Jzoe-hub/NightSecurityProject/docs/交接提示词_2026-07-17.md

# 项目交接提示词 — 2026-07-30

## 一、项目目标

在 STM32F103C8T6 硬件平台上从零构建一套**独居女性安防系统**：

- FreeRTOS 实时操作系统（10 个任务，当前 6 个已运行）
- MQTT 双向通信（ESP8266 + JSON，Phase 3）
- OTA 固件升级（Phase 4）
- Android APP（MVVM + Kotlin，Phase 5）
- 全部代码由 CubeMX 生成工程框架，原生 FreeRTOS API（xTaskCreate/vTaskDelay）写业务代码

**参考原项目**：`D:\keil.project2\NightSecurityProject\女性独家安防系统\`（裸机架构，算法和硬件接线可借鉴，代码不复用）。

---

## 二、真源文档（唯一事实来源）

| 文档 | 路径 | 说明 |
|---|---|---|
| **重构计划** | `docs/重构计划_从零开始.md` | 技术决策、配置、任务/IPC/算法设计，**权威文档** |
| 项目说明书 | `docs/项目说明书.md` | 系统框架、硬件、算法权重、状态机、MQTT协议、Phase规划 ✅ 已重写 |
| 调试手册 | `docs/调试手册.md` | 逐步测试指南 ✅ 已对齐当前代码 |
| 技术学习笔记 | `docs/技术学习笔记.md` | 学习记录（ADC坑、ppm换算、双电压等） |
| Git 使用教程 | `docs/Git使用教程.md` | Git 操作参考（含拆分commit方法） |

**任何技术决策以重构计划为准。所有修改涉及设计变更时同步更新重构计划。**

---

## 三、已完成阶段

### Phase 1 — 基础环境搭建（✅）

- CubeMX 完整配置（72MHz SYSCLK, FreeRTOS, 全部外设含 IWDG）
- 13/14 个 Lib 驱动完成（仅 esp8266 留空）
- ADC1 三通道扫描（CH0=M2Q, CH1=MQ7, CH4=火焰），TIM3 TRGO 触发 + DMA 循环搬运
- OLED I2C 驱动（百问网韦东山）+ ascii_font 字库
- OLED_Printf 已撤回（newlib-nano `%f` 需 `-u _printf_float` 链接选项）

### Phase 2 — FreeRTOS 任务（✅ 基本完成，本地调试中）

6 个任务已创建并运行：
| 任务 | 优先级 | 栈 | 周期 | 功能 |
|---|---|-----|---|---|
| SensorTask | 3 | 256 | 100ms | 读 8 类传感器，打包发队列 |
| SecurityTask | 4 | 512 | 100ms | 火灾/入侵评分 + 状态机 |
| AlarmTask | 5 | 256 | 50ms | 声光报警时序 |
| UITask | 2 | 384 | 200ms | OLED 三页 + 按键菜单 |
| FingerTask | 2 | 384 | 事件 | 指纹验证（已注释，等硬件） |
| WatchdogTask | 6 | 128 | 500ms | 心跳监控 + IWDG 喂狗 |

IPC 队列：`g_sensorQueue`（Sensor→Security）、`g_securityQueue`（Security→Alarm）

### 已完成的功能模块

- 传感器→判定→报警 完整链路
- 布防/撤防（KEY2 切换，全局变量 `g_sw_armed`，撤防=纯监控不报警）
- OLED 界面：监控页（传感器数据+ARM状态）/ 设置页（5 项阈值+方向调节）/ 报警页（霸屏+KEY1撤防退出）
- 阈值可调且 SecurityTask 实时生效
- 看门狗心跳监控（finger 心跳已注释）
- 蜂鸣器极性已确认（低电平触发，On=RESET/Off=SET）

---

## 四、当前进度 — Phase 2 本地调试

**编译通过，6 个任务运行。本地功能基本跑通。**

待完成：
- 蜂鸣器极性已修，测试通过
- RGB 极性和 CubeMX PinState 待确认
- 指纹、语音模块未到货，相关代码已注释
- 传感器阈值需根据实际读数调优
- 撤防→布防→触发→报警→KEY1 解除 完整流程待实体验证

---

## 五、关键文件和模块

### 项目结构

```
software/NightSecurity/
├── Core/                          ← CubeMX 生成，只在 USER CODE 区写
│   ├── Src/main.c                 ← HAL 初始化 + 调试代码 + 启动调度器
│   ├── Src/freertos.c             ← xTaskCreate（RTOS_THREADS）+ xQueueCreate（RTOS_QUEUES）
│   └── Src/adc.c / tim.c          ← 已改: ADC 三通道扫描、TIM3 TRGO
├── Lib/                           ← 硬件驱动层（不依赖 FreeRTOS）
│   ├── inc/ + src/                ← 13/14 完成，esp8266 留空
│   └── src/ascii_font.c           ← OLED 字库（百问网）
├── Task/                          ← 任务层
│   ├── inc/task_config.h          ← 结构体、队列句柄、任务句柄、心跳、阈值 声明
│   ├── src/task_config.c          ← 句柄定义
│   ├── src/task_sensor.c          ← ✅ 完整
│   ├── src/task_security.c        ← ✅ check_fire/intrusion/state_machine/dispatch
│   ├── src/task_alarm.c           ← ✅ alarm_fire/intrusion/idle
│   ├── src/task_ui.c              ← ✅ 三页显示+按键+菜单
│   ├── src/task_finger.c          ← ✅ 验证逻辑完成（未启用）
│   └── src/task_watchdog.c        ← ✅ 心跳检查+喂狗
└── NightSecurity.ioc              ← CubeMX 配置
```

### 最近修改的关键文件

- `Task/src/task_ui.c` — OLED 三段式界面，阈值全局共享（`uint16_t th_fire` 等），UI 最后改动较多
- `Task/src/task_security.c` — `check_fire` 使用阈值变量（`th_fire/th_smoke/th_co/th_temp`），`dispatch_alarm` 只在 level>0 时发送
- `Task/src/task_alarm.c` — 撤防时强制 `mode=0` + 丢弃队列旧命令
- `Lib/src/buzzer.c` — 蜂鸣器极性修正（低电平触发: On→RESET, Off→SET）
- `Core/Src/main.c` — `g_adc_raw` 去掉 static 供其他文件使用

---

## 六、下一步任务

### 立即可做

1. **本地调试** — 按 `docs/调试手册.md` 逐步验证：传感器读数、按键操作、布防报警、阈值调节
2. **阈值调优** — 实际测试环境中的传感器数值，调整 `th_fire/th_smoke/th_co/th_temp/th_pir`
3. **RGB 极性确认** — 共阳低亮逻辑已写对，CubeMX 初始 PinState 需确认
4. **SensorTask 加滤波** — 当前传感器原始值直接传给 SecurityTask，加上卡尔曼/EWMA 可减少误报（参考 `docs/重构计划_从零开始.md` 5.2 节）

### 模块到货后

5. 指纹（ZW101）→ 取消 FingerTask 注释，启用看门狗 finger 心跳
6. 语音（JQ8900）→已在 AlarmTask 中预留 `Voice_IO1/2_Trigger()`
7. ESP8266 → Phase 3，写 esp8266.c + CommTask + EspRxTask

### 后续 Phase

| Phase | 内容 |
|---|---|
| Phase 3 | MQTT + ESP8266 联网 |
| Phase 4 | OTA 固件升级 |
| Phase 5 | Android APP (Kotlin MVVM) |
| Phase 6 | 卡尔曼/EWMA 滤波 + 磨损均衡 |

---

## 七、Agent 宪法（必须遵守）

1. **重构计划是唯一事实来源** — 技术争论以 `docs/重构计划_从零开始.md` 为准
2. **先读计划再动手** — 先 Read 相关章节
3. **CubeMX USER CODE 区** — `freertos.c` 和 `main.c` 只在 USER CODE 标记之间写
4. **原生 FreeRTOS API** — `xTaskCreate`/`vTaskDelay`，不用 CMSIS_V2 的 `osThreadNew`
5. **Lib 不依赖 FreeRTOS** — 驱动层只提供纯逻辑接口
6. **一个文件一个模块** — Lib 12 个独立驱动 + Task 10 个任务文件
7. **计划同步** — 技术决策变更必须更新重构计划
8. **Git 提交粒度** — 每完成一小功能就 commit
9. **PC13 不用** — 驱动能力不足
10. **注释风格** — 中文盒式（函数名称/功能描述/输入参数/返回值），宏/变量一行注释，函数盒式可以详细
11. **代码注释禁止引用文档路径** — 代码只描述自身，文档归文档
12. **宏/变量注释只写一行"是什么"** — 原理推导放 docs，不放代码
13. **来源标注** — 每个驱动文件标注原作者（辰哥/百问网/GitHub 等）
14. **用户写代码，Agent 指导** — 不要未经允许自己改函数体，只写框架骨架和注释

---

## 八、验收标准

| 阶段 | 验收条件 |
|---|---|
| Phase 2 本地 | OLED 三页切换正常、按键布防/撤防、传感器数值变化、布防触发报警、撤防不报警、阈值调节生效 |
| Phase 2 稳定 | 蜂鸣器+RGB 按报警等级动作、看门狗正常、长时间运行不崩溃 |
| Phase 3 MQTT | APP 能看到实时传感器数据、能远程布防/撤防 |
| Phase 4 OTA | 一次完整固件升级成功 |
| Phase 5 APP | 数据展示+阈值调节+报警推送 |

---

## 九、已知风险

| 风险 | 影响 | 缓解 |
|---|---|---|
| 克隆 ST-Link 不稳定 | 调试困难 | ST-Link GDB server + Under Reset + Hardware reset 模式；备选 BOOT0 擦除 |
| SRAM 仅 20KB | 10 个任务可能栈溢出 | `CHECK_FOR_STACK_OVERFLOW`=Option1，每个任务用 `uxTaskGetStackHighWaterMark()` 实测 |
| PC13 备份域 | 不能做输出 | 已放弃，用 PA5（蜂鸣器）和 RGB |
| CubeMX 重新生成 | 覆盖手写代码 | 手写代码只在 USER CODE 区 |
| Flash 寿命 10K 次 | 日志写入磨损 | Phase 6 做磨损均衡 |
| 蜂鸣器/RGB 极性 | 声光效果反了 | Buzzer 已修正（低触发），RGB 代码正确，PinState 待确认 |
| 指纹模块心跳 | FingerTask 死等会误触发看门狗 | 已注释，启用前把 `g_heartbeat_finger++` 放在 `finger_wait_touch` 之前 |
| 报警队列旧数据 | 撤防后残留报警命令 | AlarmTask 撤防时丢弃队列 + force mode=0 |
| 传感器阈值硬编码 | 与设置页不联动 | 已改为全局变量 `th_fire/th_smoke/th_co/th_temp/th_pir`，UI 和 SecurityTask 共享 |
