Jzoe-hub/NightSecurityProject/docs/重构计划_从零开始.md

# 女性安防系统 — 从零重构计划

> **原则**：完全从 STM32CubeMX 开始配置，重新生成工程，不复用现有裸机代码的架构，只复用硬件驱动逻辑。

---

## 一、项目目标

在现有硬件基础上，从零构建一个：

- **FreeRTOS** 实时操作系统驱动
- **MQTT** 双向通信（TLS 加密 + 遗嘱消息 + 心跳）
- **OTA 固件升级**（ESP8266 下载 → STM32 Bootloader 校验写入）
- **Android APP 重构**（MVVM + 通知 + 图表 + 多设备管理）

的**独居女性安防系统**。

---

## 二、硬件资源总览

| 资源 | 型号 | 接口 | 占用引脚 |
| --- | --- | --- | --- |
| MCU | STM32F103C8T6  | — | — |
| WiFi | ESP8266-01S | USART2 | PA2(TX), PA3(RX) |
| 烟雾传感器 | MQ-2 | ADC1_CH0 | PA0 |
| CO 传感器 | MQ-7 | ADC1_CH1 | PA1 |
| 火焰传感器 | 火焰模块(四线) | ADC1_CH4 + GPIO | PA4(AO), PA11(DO) |
| PIR 人体红外 | HC-SR501 | GPIO | PA8 |
| 人体雷达 | LD2410C | USART1 | PA9(TX), PA10(RX) |
| 温湿度 | DHT11 | GPIO | PA12 |
| 指纹模块 | ZW101 | USART3 | PB10(TX), PB11(RX) |
| 指纹触摸 | ZW101 TOUCH | GPIO | PA6 |
| OLED | 0.96寸 I2C | I2C1 | PB8(SCL), PB9(SDA) |
| 语音模块 | JQ8900 | GPIO | PB6(IO1), PB7(IO2), PB3(IO3), PB4(IO4), PB12(BUSY) |
| 蜂鸣器 | 有源蜂鸣器 | GPIO | PA5 |
| RGB LED | 共阳RGB | GPIO | PB0(R), PB1(G), PA7(B) |
| 按键 ×3 | 轻触按键 | GPIO | PB13(K1), PB14(K2), PB15(K3) |

**Flash 规划（64KB）：**

| 区域 | 大小 | 地址 |
| --- | ---- | --- |
| Bootloader  | 16KB | 0x08000000 - 0x08003FFF |
| Application | 44KB | 0x08004000 - 0x0800EFFF |
| Config/Log  | 4KB  | 0x0800F000 - 0x0800FFFF |

---

## 三、CubeMX 配置清单

### 3.1 基础配置

```
MCU: STM32F103C8T6
Package: LQFP48
Clock: HSE 8MHz → PLL ×9 → SYSCLK 72MHz
       APB1 = 36MHz, APB2 = 72MHz
Debug: Serial Wire (SWD) — PA13, PA14（关闭 JTAG，释放 PB3/PB4 给 JQ8900）
Timebase: TIM4（SysTick 专供 FreeRTOS，TIM4 专供 HAL，避免抢占冲突）
```

### 3.2 FreeRTOS 配置

```
Middleware → FREERTOS → Interface: CMSIS_V2

Kernel Setting:
  - configUSE_PREEMPTION           = 1
  - configCPU_CLOCK_HZ            = SystemCoreClock (72MHz)
  - configTICK_RATE_HZ            = 1000
  - configMAX_PRIORITIES          = 56       (CMSIS_V2 固定: 7组×8子优先级)
  - configMINIMAL_STACK_SIZE      = 128 Words
  - configTOTAL_HEAP_SIZE         = 10240    (10KB, 保守)
  - configMAX_TASK_NAME_LEN       = 16
  - configUSE_16_BIT_TICKS        = Disabled (0 → 32位, 最长49.7天不溢出)
  - configIDLE_SHOULD_YIELD       = Enabled
  - configCHECK_FOR_STACK_OVERFLOW = Option 1 (开发阶段必开, 任务栈溢出时检测)
  - configUSE_MUTEXES             = Enabled
  - configUSE_RECURSIVE_MUTEXES   = Enabled
  - configUSE_COUNTING_SEMAPHORES = Enabled
  - configUSE_QUEUE_SETS          = Enabled (SecurityTask 同时等传感器队列+命令队列)
  - configUSE_TASK_NOTIFICATIONS  = Enabled (WatchdogTask 心跳检测, 比信号量快)
  - configUSE_TIMERS              = Enabled
  - configTIMER_TASK_STACK_DEPTH  = 256
  - configTIMER_QUEUE_LENGTH      = 10
  - configTIMER_TASK_PRIORITY     = 2

Memory Management:
  - Memory Allocation: Dynamic / Static
  - TOTAL_HEAP_SIZE: 10240 Bytes
  - Memory Management scheme: heap_4 (支持相邻空闲块合并, 避免碎片化)

CMSIS_V2 标志 (CubeMX 自动配置):
  - USE_OS2_THREAD_SUSPEND_RESUME = 1  (对应 vTaskSuspend)
  - USE_OS2_THREAD_ENUMERATE      = 1
  - USE_OS2_EVENTFLAGS_FROM_ISR   = 1
  - USE_OS2_THREAD_FLAGS          = 1  (任务通知)
  - USE_OS2_TIMER                 = 1
  - USE_OS2_MUTEX                 = 1

注意: USE_IDLE_HOOK = Disabled, 看门狗喂狗不放在空闲钩子,
     而是由 WatchdogTask (优先级6) 每500ms检查各任务心跳后统一喂狗
```

### 3.3 外设配置

#### ADC1（烟雾 + CO + 火焰）

```
ADC1 → Channel 0 (PA0): MQ-2 烟雾传感器          → Rank 1
ADC1 → Channel 1 (PA1): MQ-7 CO 传感器           → Rank 2
ADC1 → Channel 4 (PA4): 火焰传感器 AO (四线模块)  → Rank 3
Mode: Independent mode, Continuous conversion = DISABLE
Scan Conversion Mode: Enabled (Number Of Conversion 改 3 后自动启用)
Number Of Conversion: 3
External Trigger Conversion Source: Timer 3 Trigger Out event (默认软件触发, 必须手动改)
Sampling Time: 239.5 Cycles (3 个 Rank 都要设)
DMA: DMA1 Channel1, Circular, Half-Word (扫描 3 个通道)

⚠️ CubeMX 坑 (2026-07-17 踩坑记录):
   Mode 面板勾选 IN0/IN1/IN4 只是把引脚配成模拟输入, 不会进入转换序列;
   必须在 Parameter Settings 把 Number Of Conversion 改为 3 并逐 Rank 分配通道,
   否则生成代码 NbrOfConversion=1, 只转换 CH0 一个通道。
   触发源同理: 默认 ADC_SOFTWARE_START, 须手动选 Timer 3 Trigger Out event,
   且 TIM3 侧 Trigger Event Selection 必须选 Update Event, 两头都配才通。
```

#### USART1（LD2410C 雷达）

```
Mode: Asynchronous
Baud Rate: 25600
Word Length: 8 Bits, Parity: None, Stop Bits: 1
RX Pin: PA10, TX Pin: PA9
NVIC: USART1 Global Interrupt = ENABLE
DMA: DMA1 Channel5 (RX), Circular, Byte

注意: LD2410C 默认波特率为 25600，帧头为 FD FC FB FA
```

#### USART2（ESP8266 WiFi 模块）

```
Mode: Asynchronous
Baud Rate: 115200
Word Length: 8 Bits, Parity: None, Stop Bits: 1
RX Pin: PA3, TX Pin: PA2
NVIC: USART2 Global Interrupt = ENABLE
DMA: DMA1 Channel6 (RX), Circular, Byte
```

#### USART3（ZW101 指纹模块）

```
Mode: Asynchronous
Baud Rate: 57600
Word Length: 8 Bits, Parity: None, Stop Bits: 1
RX Pin: PB11, TX Pin: PB10
NVIC: USART3 Global Interrupt = ENABLE

注意: ZW101 协议与 AS608 兼容(同为 EF01 帧头 + FFFFFFFF 地址码 + 校验和)，
      PIN1 V_SENSOR 必须常接 3.3V 供电(否则无法采指纹图像)
```

#### I2C1（OLED 显示屏）

```
Mode: I2C
Speed: Fast Mode (400KHz)
SCL: PB8, SDA: PB9
```

#### TIM2（微秒时基 / DHT11 时序）

```
Clock Source: Internal Clock
Prescaler: 72-1 → 1MHz (1µs tick)
Counter Period: 65535 → 最大计时 65ms
NVIC: TIM2 Global Interrupt = ENABLE

作用：FreeRTOS vTaskDelay 最小单位 1ms, DHT11 需要 µs 级延时
      (起始信号 18ms, 应答 80µs), 用 TIM2 的 CNT 计数器实现 delay_us()
```

#### TIM3（传感器采样定时器）

```
Clock Source: Internal Clock
Prescaler: 7200-1 → 10KHz
Counter Period: 1000-1 → 100ms 周期
Trigger Output: Update Event (TRGO) → 触发 ADC 转换
NVIC: TIM3 Global Interrupt = ENABLE

作用：硬件定时器 100ms 精确触发 ADC 采样, 比 vTaskDelay 累积误差更小
      在 HAL_TIM_PeriodElapsedCallback 中调用 HAL_ADC_Start_DMA()
```

#### GPIO 输入

```
PA6  - ZW101 TOUCH     (浮空输入, EXTI 上升沿中断, 模块主动输出, 1=活体真/0=活体假)
PB5  - LD2410C OT1     (浮空输入, EXTI 双沿中断, 有人=高电平 无人=低电平)
PA8  - HC-SR501 PIR    (浮空输入)
PA11 - 火焰传感器 DO    (上拉输入, 数字过阈值触发)
PB12 - JQ8900 BUSY     (浮空输入)
PB13 - K1 按键         (上拉输入, EXTI 下降沿中断)
PB14 - K2 按键         (上拉输入, EXTI 下降沿中断)
PB15 - K3 按键         (上拉输入, EXTI 下降沿中断)
```

#### GPIO 输出

```
PA5  - 蜂鸣器       (推挽输出, 低电平触发)
PA7  - RGB-B (蓝灯) (推挽输出, 低电平有效)
PB0  - RGB-R (红灯) (推挽输出, 低电平有效)
PB1  - RGB-G (绿灯) (推挽输出, 低电平有效)
PB6  - JQ8900 IO1   (推挽输出, 低电平脉冲触发) — 火灾报警
PB7  - JQ8900 IO2   (推挽输出, 低电平脉冲触发) — 入侵报警
PB3  - JQ8900 IO3   (推挽输出, 低电平脉冲触发) — 指纹认证成功
PB4  - JQ8900 IO4   (推挽输出, 低电平脉冲触发) — 撤防成功
PA12 - DHT11 DATA   (开漏输出, 需要切换输入/输出)
PB12 - JQ8900 BUSY  (输入, 播放中=高电平)
```

#### IWDG（独立看门狗）

```
Prescaler: 64 → IWDG_CLK = 40KHz LSI ÷ 64 = 625Hz
Reload: 625 → 超时 ≈ 1.6s
喂狗方式: WatchdogTask (优先级6) 每500ms检查各任务心跳后 HAL_IWDG_Refresh()

注意: 不放在空闲钩子。空闲任务可能在正常阻塞时一直跑(假健康),
      WatchdogTask 通过任务心跳检测能发现"某个关键任务死了但空闲任务还在跑"的真死机。
```

#### RTC（实时时钟）

```
配置步骤:
  1. System Core → RCC → Low Speed Clock (LSE) → Crystal/Ceramic Resonator
  2. System Core → RTC → Activate Clock Source (勾上即可, 自动走 LSE)
  3. Calendar Time/Date 设初始值 (后续通过 MQTT 从 APP 同步校准)

Clock Source: LSE (外部 32.768KHz 晶振), 精度远高于内部 LSI

用途: Phase 2 报警日志时间戳 + 定时布防/撤防 (如"每晚22:00自动布防")
```

---

## 四、FreeRTOS 任务设计

### 4.1 任务总表

| 任务名 | 优先级 | 栈大小 | 周期/触发 | 核心职责 |
| --- | --- | --- | --- | --- |
| `SensorTask` | 3 (Normal)  | 256 | 100ms | 读取所有传感器，滤波，发布传感器事件 |
| `SecurityTask` | 4 (High) | 512 | 100ms | 火灾/入侵融合判定，状态机运转，**定时布防/撤防调度** |
| `AlarmTask` | 5 (Highest) | 256 | 50ms | 声光报警时序（蜂鸣器PWM、RGB闪烁、语音触发） |
| `CommTask` | 3 (Normal)  | 512 | 事件驱动  | MQTT 协议包装/解析，JSON 构建/解析 |
| `EspRxTask` | 4 (High) | 256 | 事件驱动  | ESP8266 串口数据接收、帧同步 |
| `UITask` | 2 (Low) | 384 | 200ms | OLED 刷新，按键响应，菜单状态机 |
| `FingerTask` | 2 (Low) | 384 | 事件驱动  | 指纹录入/验证/删除流程 |
| `OTATask` | 1 (Lowest)  | 512 | 按需 | OTA 固件接收、Flash 写入、校验 |
| `WatchdogTask` | 6 (Max-1) | 128 | 500ms | 各任务心跳检测 + IWDG 喂狗 |
| `LogTask` | 1 (Lowest)  | 256 | 按需 | 报警日志写入内部 Flash |

#### 4.1.1 优先级设计原则

FreeRTOS 数值越大优先级越高（configMAX_PRIORITIES = 7）。

**第一层：安全优先**

- 报警(5) 和安全判定(4) 不能等 — 传感器数据过了 100ms 就旧了, 判定延迟直接导致误报/漏报
- 看门狗(6) 最最高 — 它喂不了狗整个系统重启, 任何其他任务卡死不能拖累 Watchdog

**第二层：实时性决定**

- 数据接收(4) 高于数据处理(3) — 串口缓冲区溢出是不可恢复的数据丢失, 处理慢一点只影响延迟
- 定时采样(3) 高于事件驱动(2/1) — SensorTask 每 100ms 必须准时跑, vTaskDelayUntil 保证周期

**第三层：不卡交互**

- 人眼刷新 200ms 够用 — UITask(2) 再高无意义, 浪费 CPU
- 指纹录入一次几秒 — FingerTask(2) 只对用户体验敏感, 不对安全敏感
- OTA/Log(1) — 后台活, 系统闲时再跑, 不丢数据就行

```
优先级链: Watchdog(6) > Alarm(5) > Security(4) ≈ EspRx(4)
         > Sensor(3) ≈ Comm(3) > UI(2) ≈ Finger(2) > OTA(1) ≈ Log(1)
```

#### 4.1.2 栈大小估算与验证

栈值（单位 word × 4 Byte = 字节）来自两部分估计, Phase 2 用 `uxTaskGetStackHighWaterMark()` 实测调优。

**估算依据**

| 因素 | 栈消耗 | 本项目中典型例子 |
| --- | --- | --- |
| 局部变量 (数组/缓冲区) | N × sizeof(type) | char buf[64] 占 64 字, uint16_t dma_buf[3] 少 |
| sprintf / printf | 一次性吃掉 100-200 字 | CommTask JSON 格式化, UITask 显示格式化 |
| 函数调用链 | 每层 ~8-16 字 | SecurityTask: Lib 驱动 → 队列 → 状态机, 4-5 层 |
| FreeRTOS 内核开销 | 每任务约 60 字 | 任务控制块 + 上下文保存 (Cortex-M3) |

各任务估算逻辑:

- SecurityTask(512): 状态机变量 + 队列操作 + 传感器融合算法, 调用链最深
- CommTask(512): JSON 构建/解析需要 sprintf 缓冲区, 一次几百字节
- OTA(512): Flash 页缓冲区(256Byte) + 校验计算
- UI/Finger(384): OLED 显示需要字符串缓冲区 + 菜单状态机变量
- Sensor/Alarm/EspRx(256): 队列操作为主, 局部变量少
- Watchdog(128): 只有心跳检查 + `HAL_IWDG_Refresh()`, 几乎无局部变量

**实测验证方法**

```c
// 在任务函数的 while(1) 循环末尾加:
UBaseType_t uxHighWaterMark = uxTaskGetStackHighWaterMark( NULL );
// 含义: 任务运行历史上栈还剩多少字没被用到
```

| 返回值 | 结论 |
| --- | --- |
| < 50 | 危险, 接近溢出, 立即加大栈 |
| 50-100 | 偏紧, 留一点余量即可 |
| > 100  | 安全, 甚至可考虑减小以省 RAM |

**总栈开销**: 256+512+256+512+256+384+384+512+128+256 = 3456 字 ≈ 13.8KB
加上 FreeRTOS 堆默认约 10KB, 逼近 20KB SRAM 上限。Phase 2 联调前需在 CubeMX 将 `TOTAL_HEAP_SIZE` 从默认值降至 6-8KB, 并从 `uxTaskGetStackHighWaterMark` 返回值反向调优各任务栈值。

CubeMX 中 `CHECK_FOR_STACK_OVERFLOW` 必须选 Option 1 (调度器在任务切换时检查栈指针)。

### 4.2 任务间通信（IPC）

```

SensorTask ──Queue──→ SecurityTask     (传感器数据包)
SecurityTask──Queue──→ AlarmTask       (报警命令: 类型/等级)
SecurityTask──Queue──→ CommTask        (状态上报请求)
CommTask ──Queue──→ SecurityTask       (APP 下发命令: 布防/撤防/阈值)
CommTask ──Queue──→ OTATask            (OTA 数据块)
EspRxTask ──Queue──→ CommTask          (ESP8266 原始帧)
FingerTask──EventGroup→ SecurityTask   (指纹验证结果事件)
SecurityTask──Queue──→ LogTask         (报警日志写入)
Key ISR ──Queue──→ UITask              (按键事件)
```

### 4.3 共享资源保护

| 资源 | 保护方式 |
| --- | --- |
| 雷达环形缓冲区`radar_buf` | `xSemaphoreTakeMutex` |
| Flash 读写 | `xSemaphoreTakeMutex`（禁止重入） |
| UART 发送缓冲区 | `xSemaphoreTakeMutex` |
| 系统配置参数 | `xSemaphoreTakeMutex` |

### 4.4 代码文件结构

```
NightSecurity/
├── Core/                        ← CubeMX 生成, 只在 USER CODE 区写
│   ├── Inc/                     ← 头文件 (不改)
│   ├── Src/
│   │   ├── main.c               ← HAL 初始化 + 启动调度器 (不改)
│   │   ├── freertos.c           ← USER CODE Init 建 IPC + RTOS_THREADS 建任务
│   │   └── gpio.c / adc.c ...   ← HAL 初始化 (不改)
│   └── Startup/
│
├── Drivers/                     ← ST 官方 HAL + CMSIS (不动)
├── Middlewares/                 ← FreeRTOS 源码 (不动)
│
├── Lib/                         ← 新建: 硬件驱动层
│   ├── inc/                     ← 头文件集中
│   │   ├── mq2.h                ← MQ-2 烟雾 (PA0 ADC)
│   │   ├── mq7.h                ← MQ-7 CO (PA1 ADC)
│   │   ├── fire.h               ← 火焰传感器 AO+DO (PA4+PA11)
│   │   ├── dht11.h              ← DHT11 温湿度
│   │   ├── pir.h                ← PIR HC-SR501
│   │   ├── radar.h              ← LD2410C 串口协议
│   │   ├── finger.h             ← ZW101 指纹 AT 指令
│   │   ├── voice.h              ← JQ8900 语音触发
│   │   ├── oled.h               ← SSD1306 I2C 驱动
│   │   ├── key.h                ← 按键扫描 + 消抖
│   │   ├── esp8266.h            ← ESP8266 串口帧收发
│   │   ├── buzzer.h             ← 蜂鸣器
│   │   └── rgb.h                ← RGB LED
│   └── src/                     ← 源文件集中
│       ├── mq2.c / mq7.c / fire.c              ← ADC 驱动 (MQ-2/MQ-7/火焰)
│       ├── dht11.c / pir.c / flame.c
│       ├── radar.c / finger.c / voice.c / oled.c
│       ├── key.c / esp8266.c / buzzer.c / rgb.c
│
├── Task/                        ← 新建: 任务函数 + 全局配置
│   ├── inc/
│   │   └── task_config.h        ← 所有句柄、队列、互斥量 extern 声明
│   └── src/
│       ├── task_config.c        ← 变量定义 + Task_Config_Init()
│       ├── task_sensor.c        ← SensorTask() 读取传感器, 发布数据
│       ├── task_security.c      ← SecurityTask() 火灾 + 入侵判定
│       ├── task_alarm.c         ← AlarmTask() 声光报警
│       ├── task_ui.c            ← UITask() OLED 刷新 + 按键响应
│       ├── task_comm.c          ← CommTask() + EspRxTask()
│       ├── task_finger.c        ← FingerTask()
│       ├── task_ota.c           ← OTATask()
│       ├── task_watchdog.c      ← WatchdogTask()
│       └── task_log.c           ← LogTask()
│
├── NightSecurity.ioc
└── STM32F103C8TX_FLASH.ld
```

**层级关系** (只能上层调用下层):

```
Task/      ← 任务函数, 用 FreeRTOS IPC + 调用 Lib
  ↓
Lib/       ← 纯硬件驱动, 不依赖 FreeRTOS
  ↓
Core HAL   ← STM32 初始化
```

**CubeIDE 配置**: Lib/ 和 Task/ 创建后, 在 CubeIDE 项目属性里把这两个文件夹加入 Include Path 和 Source Path, 编译器就认了。

### 4.5 freertos.c 里怎么写

**USER CODE Init** — 创建 IPC 和全局初始化:

```c
void MX_FREERTOS_Init(void) {
  /* USER CODE BEGIN Init */
  g_sensorQueue = xQueueCreate(16, sizeof(SensorData_t));
  g_alarmQueue  = xQueueCreate(8,  sizeof(AlarmCmd_t));
  g_i2cMutex    = xSemaphoreCreateMutex();
  Task_Config_Init();   /* 初始化 task_config 里定义的变量 */
  /* USER CODE END Init */
  // ...
}
```

**USER CODE RTOS_THREADS** — 只建任务, 写任务函数名即可:

```c
  /* USER CODE BEGIN RTOS_THREADS */
  xTaskCreate(SensorTask,   "Sensor",   256, NULL, 3, &g_sensorTaskHandle);
  xTaskCreate(SecurityTask, "Security", 512, NULL, 4, &g_securityTaskHandle);
  xTaskCreate(AlarmTask,    "Alarm",    256, NULL, 5, &g_alarmTaskHandle);
  xTaskCreate(UITask,       "UI",       384, NULL, 2, &g_uiTaskHandle);
  xTaskCreate(CommTask,     "Comm",     512, NULL, 3, &g_commTaskHandle);
  xTaskCreate(EspRxTask,    "EspRx",    256, NULL, 4, &g_espRxTaskHandle);
  xTaskCreate(FingerTask,   "Finger",   384, NULL, 2, &g_fingerTaskHandle);
  xTaskCreate(OTATask,      "OTA",      512, NULL, 1, &g_otaTaskHandle);
  xTaskCreate(WatchdogTask, "Watchdog", 128, NULL, 6, &g_watchdogTaskHandle);
  xTaskCreate(LogTask,      "Log",      256, NULL, 1, &g_logTaskHandle);
  /* USER CODE END RTOS_THREADS */
```

**task_config.h** — 集中声明:

```c
#ifndef TASK_CONFIG_H
#define TASK_CONFIG_H

#include "FreeRTOS.h"
#include "task.h"
#include "queue.h"
#include "semphr.h"

/* ---- 句柄 ---- */
extern TaskHandle_t g_sensorTaskHandle;
extern TaskHandle_t g_securityTaskHandle;
extern TaskHandle_t g_alarmTaskHandle;
// ... 其余句柄

/* ---- 队列 ---- */
extern QueueHandle_t g_sensorQueue;
extern QueueHandle_t g_alarmQueue;
extern QueueHandle_t g_cmdQueue;

/* ---- 互斥量 ---- */
extern SemaphoreHandle_t g_i2cMutex;

/* ---- 函数 ---- */
void Task_Config_Init(void);

#endif
```

**task_config.c** — 定义 + 初始化:

```c
#include "task_config.h"

/* 句柄定义 */
TaskHandle_t g_sensorTaskHandle = NULL;
TaskHandle_t g_securityTaskHandle = NULL;
// ...

/* 队列定义 */
QueueHandle_t g_sensorQueue = NULL;
QueueHandle_t g_alarmQueue = NULL;

/* 互斥量定义 */
SemaphoreHandle_t g_i2cMutex = NULL;

/* 初始化 (在 freertos.c 的 USER CODE Init 里调用) */
void Task_Config_Init(void) {
    /* 这里放需要在调度器启动前初始化的东西 */
}
```

**task_sensor.c 示例** — 任务函数:

```c
#include "task_config.h"
#include "lib_sensor.h"
#include "main.h"

void SensorTask(void *param) {
    TickType_t xLastWakeTime = xTaskGetTickCount();
    for (;;) {
        /* 读全部传感器 */
        SensorData_t data;
        Sensor_ReadAll(&data);

        /* 发给 SecurityTask */
        xQueueSend(g_sensorQueue, &data, 0);

        vTaskDelayUntil(&xLastWakeTime, pdMS_TO_TICKS(100));
    }
}
```

**I2C 互斥量封装** (参考工程风格):

```c
void GetI2C(void) { xSemaphoreTake(g_i2cMutex, portMAX_DELAY); }
void PutI2C(void) { xSemaphoreGive(g_i2cMutex); }
```

## 五、核心模块设计

### 5.0 LD2410C 雷达协议解析

```

═══════════════════════════════════════════
LD2410C 数据帧格式 (UART 上报)
═══════════════════════════════════════════

帧结构 (固定长度 30 字节):
┌──────┬──────┬──────┬──────┬─────┬─────┬─────┬─────┬─────┬─────┬─────┬─────┬──────┬──────┬──────┬──────┬──────┬──────┬──────┬──────┬──────┬──────┬──────┬──────┐
│  FD  │  FC  │  FB  │  FA  │ LEN │ STA │ MOT │ EN_M│ EN_S │ DIS │     │M_DIST│     │S_DIST│     │M_DIST│     │S_DIST│     │M_DIST│     │S_DIST│     │ CHK  │  END  │
│ 0xFD │ 0xFC │ 0xFB │ 0xFA │0x1A │     │     │     │     │_M_L │     │(LSB) │     │(LSB) │     │  #2  │     │  #2  │     │  #3  │     │  #3  │     │      │ 0x55  │
└──────┴──────┴──────┴──────┴─────┴─────┴─────┴─────┴─────┴─────┴─────┴──────┴──────┴──────┴──────┴──────┴──────┴──────┴──────┴──────┴──────┴──────┴──────┴──────┘

关键字段:
  STA (State):        bit0=有人/无人, bit1=运动触发, bit2=静止触发
  MOT (Motion):       0=无运动目标, 1=有运动目标
  EN_M (Motion Energy): 运动能量值 0-100
  EN_S (Static Energy): 静止能量值 0-100
  DIS_M_L/H:           运动目标距离 (cm)
  S_DIST_L/H:          静止目标距离 (cm)
  CHK:                 校验和 (前 28 字节累加取低 8 位)
  END:                 0x55 帧尾

OT1 引脚:

- 输出高低电平指示是否有人 (可通过上位机配置)
- 高电平 = 有人 (运动或静止)
- 低电平 = 无人
- 接 STM32 PA4, EXTI 双沿中断 → 快速响应人员进入/离开
- UART 数据作二级确认 (防止 OT1 毛刺误触发)

解析流程:

1. DMA 循环接收 USART1 数据到环形缓冲区
2. 在 SensorTask 中扫描帧头 FD FC FB FA
3. 验证 LEN == 0x1A 且帧尾 == 0x55
4. 累加校验和验证
5. 提取: has_motion, has_static, motion_energy, static_energy, motion_dist, static_dist
6. 发布到 SecurityTask 的消息队列
```

### 5.1 安全状态机

```

    ┌──────────────────────────────────────┐
                    │            SYSTEM STATES               │
                    │                                        │
                    │  ┌──────┐   K3/APP/指纹   ┌─────────┐ │
                    │  │ IDLE │◄─────────────────│ ARMED   │ │
                    │  │ 闲   │─────────────────►│ 布防    │ │
                    │  └──┬───┘   K3/APP/指纹    └────┬────┘ │
                    │     │                           │       │
                    │     │              ┌────────────┼────┐  │
                    │     │              ▼            ▼    │  │
                    │     │         ┌─────────┐ ┌────────┐ │  │
                    │     │         │WARNING  │ │ ALARM  │ │  │
                    │     │         │预报警    │─► 报警  │ │  │
                    │     │         │(单传感器)│ │(确认)  │ │  │
                    │     │         └────┬────┘ └───┬────┘ │  │
                    │     │              │          │      │  │
                    │     │    超时无确认│   指纹/APP解除   │  │
                    │     │              ▼          │      │  │
                    │     │         ┌─────────┐     │      │  │
                    │     │         │ ALARM   │◄────┘      │  │
                    │     │         │ (最终)  │             │  │
                    │     └─────────┴─────────┴────────────┘  │
                    └──────────────────────────────────────┘
```

### 5.2 采样滤波算法

#### Kalman + EWMA 联合滤波 (Phase 6 实现)

对 MQ-2/MQ-7 等模拟量传感器, 采用两级滤波:

```
ADC 原始值 → Kalman(抑制突变) → EWMA(去除毛刺) → 稳定值
```

- **Kalman 滤波**: 对传感器物理过程建模, 预测下一时刻值, 与实际值融合。
  对缓慢变化的气体浓度效果显著, 能压制 ADC 瞬时尖峰。
- **EWMA**: `S_new = α × S_old + (1-α) × V_new`, α ≈ 0.3~0.4。
  加在 Kalman 之后再平滑一次, 消除残余抖动。

#### EWMA 入侵置信度平滑

```
入侵原始分 → EWMA(filter=40) → 平滑后的入侵置信度 val_intrusion
```

- PIR 可能瞬时触发一次, 雷达可能丢帧——EWMA 让置信度缓慢上升/下降,
  避免单次抖动触发报警。

#### 当前实现

Phase 2 简化: SensorTask 直接读 DMA 缓冲区, 不做软件滤波。
卡尔曼/EWMA 在 Phase 6 优化时加入。

---

### 5.3 火灾判定算法

```

输入: val_temp, val_smoke, val_gas, val_flame_ao, val_flame_do

滤波:

- smoke:      Kalman + EWMA (λ=0.15)
- gas:        Kalman + EWMA (λ=0.15)
- flame_ao:   均值滤波 (窗口=3)
- temp:        均值滤波 (窗口=5)

超阈值检测:

- temp_over   = (val_temp     >= th_temp)
- smoke_over  = (val_smoke    >= th_smoke)
- gas_over    = (val_gas      >= th_gas)
- flame_do_on = (val_flame_do > 0)           // 数字量快速触发
- flame_ao_on = (val_flame_ao >= th_flame)   // 模拟量确认

评分 (火焰权重从 5 提升到 20):
  fire_score = temp_over×70 + smoke_over×55 + gas_over×40
             + (flame_ao_on ? 20 : 0) + (flame_do_on ? 10 : 0)

状态转移:
  IDLE/ARMED:
    - flame_do 触发但 flame_ao 未达阈值 → WARNING (单独火焰数字量可能是误报)
    - 单传感器触发 → WARNING (启动 5s 确认窗口)
    - 双传感器触发 → ALARM
    - fire_score >= 60 → ALARM
  WARNING:
    - 5s 内第二个传感器触发 → ALARM
    - 5s 内原传感器消失 → IDLE/ARMED
    - 5s 超时 → 根据剩余触发源判定

四线火焰传感器优势:

- DO 用作快速触发 (与其他传感器组合判定)
- AO 提供火焰强度连续值，可设定精确阈值 + 滤波
- flame_ao + flame_do 同时触发 → 高置信度明火
```

### 5.4 入侵判定算法

```

输入: pir_raw, radar_motion_energy, radar_static_energy, radar_motion_dist, radar_static_dist

LD2410C 上报数据:

- 帧头: FD FC FB FA
- 运动目标状态: 0=无人 / 1=有人移动
- 静止目标状态: 0=无人 / 1=有人静止
- 运动能量值: 0-100 (数值越大越活跃)
- 静止能量值: 0-100 (数值越大越确定有人)
- 运动距离: cm
- 静止距离: cm

滤波:

- intrusion_value: EWMA (α=0.25)

评分:
  pir_contribution        = (pir_raw > 0) ? 70 : 0
  radar_motion_contrib     = (radar_has_motion)  ? 25 : 0
  radar_static_contrib     = (radar_has_static)  ? 50 : 0  // 静止人体 = 高置信度
  radar_nearby_contrib     = (radar_any_dist < 200cm) ? 15 : 0  // 距离近加分

  intrusion_input = pir_contribution + radar_motion_contrib
                  + radar_static_contrib + radar_nearby_contrib
  intrusion_score = Ewma_Update(&intrusion_ewma, intrusion_input)

状态转移:

- intrusion_score >= 60 → INTRUSION_ALARM
- 静止人体检测到 + 距离 < 100cm → 高置信度，直接触发 ALARM
- 仅运动检测(无静止) → 提升到 WARNING，等待二次确认

LD2410C 优势:

- 可检测静止人体(呼吸微动)，入侵者蹲伏不动也能发现
- 输出能量值可做二级滤波，比简单 0/1 更可靠
```

### 5.5 报警输出分级

| 等级 | 蜂鸣器 | RGB灯 | 语音 | APP通知 |
| --- | --- | --- | --- | --- |
| WARNING | 间歇滴答 1Hz | 黄灯闪烁 | — | 通知一次 |
| FIRE | 持续长鸣 | 红灯常亮 | "火灾警报" | 持续通知 |
| INTRUSION | 急促 4Hz | 红灯快闪 | "入侵警告" | 持续通知 |
| BOTH | 持续长鸣 | 红蓝交替 | "紧急情况" | 最高优先级 |

### 5.6 定时布防/撤防

```

═══════════════════════════════════════════
实现方案
═══════════════════════════════════════════

依赖: RTC (已在 CubeMX 配置，LSE 32.768KHz)

SecurityTask 每个周期 (100ms) 追加一步:

1. 从 RTC 读取当前 HH:MM
2. 遍历配置中的定时规则列表 (最多 N 条)
3. 如果 "当前时间 == 规则时间" 且 "今天还未触发过":
   → 布防: sw_security = 1
   → 撤防: sw_security = 0
   → 标记已触发
4. 如果 "当前时间 != 规则时间":
   → 清除触发标记 (为下一天准备)

数据结构 (存储在 Flash 配置区):
```

```c
#define MAX_SCHEDULE_RULES 8

typedef enum {
    SCHED_ACTION_ARM   = 1,  // 布防
    SCHED_ACTION_DISARM = 0,  // 撤防
} SchedAction;

typedef struct {
    uint8_t  hour;        // 0-23
    uint8_t  minute;      // 0-59
    uint8_t  action;      // 1=布防, 0=撤防
    uint8_t  repeat_mask; // bit0=周一 ... bit6=周日, 0xFF=每天
    uint8_t  enabled;     // 0=禁用, 1=启用
} ScheduleRule;

typedef struct {
    ScheduleRule rules[MAX_SCHEDULE_RULES];
    uint8_t today_triggered_bitmap; // 每 bit 对应一条规则当天是否已触发
    uint8_t last_check_day;         // 换天时清零
} ScheduleConfig;
```

典型使用场景:
  规则1: 22:00 布防, 每天 → 晚上10点自动设防
  规则2: 07:00 撤防, 每天 → 早上7点自动撤防
  规则3: 09:00 布防, 周一~周五 → 工作日出门后自动设防

防重复触发:

- 用 today_triggered_bitmap 记录每条规则今天是否已执行
- 每次 RTC 日期变更时清零
- 避免在 22:00 这一分钟内反复触发多次

### 5.7 MQTT 协议设计

```

═══════════════════════════════════════════
Topic 结构
═══════════════════════════════════════════

上行 (STM32 → ESP8266 → MQTT → APP):

women_safe/{device_id}/state        — 状态上报
women_safe/{device_id}/heartbeat    — 心跳 (30s)
women_safe/{device_id}/log          — 报警日志
women_safe/{device_id}/ota/progress — OTA 进度

下行 (APP → MQTT → ESP8266 → STM32):

women_safe/{device_id}/cmd          — 控制命令
women_safe/{device_id}/config       — 配置下发
women_safe/{device_id}/ota/start    — OTA 启动
women_safe/{device_id}/ota/data     — OTA 数据块

═══════════════════════════════════════════
消息格式
═══════════════════════════════════════════

状态上报 {
  "type": "state",
  "ts": 1625832000,
  "temp": 28.5,
  "humi": 46,
  "smoke": 2.3,
  "co": 1.1,
  "pir": 0,
  "fire": 0,
  "armed": 1,
  "alarm": 0,
  "alarm_type": 0,
  "firmware": "v1.2.0"
}

心跳 {
  "type": "heartbeat",
  "ts": 1625832000,
  "uptime": 3600,
  "free_heap": 5120,
  "wifi_rssi": -45
}

控制命令 {
  "type": "cmd",
  "action": "arm",        // arm | disarm | threshold | schedule | reboot
  "params": {
    "armed": 1
  }
}

配置下发 {
  "type": "config",
  "threshold": {
    "temp": 50,
    "smoke": 2000,
    "gas": 1500
  },
  "schedule": [
    {"hour":22, "minute":0,  "action":1, "days":[1,2,3,4,5,6,7], "enable":true},
    {"hour":7,  "minute":0,  "action":0, "days":[1,2,3,4,5,6,7], "enable":true},
    {"hour":9,  "minute":0,  "action":1, "days":[1,2,3,4,5],     "enable":false}
  ]
}

OTA 启动 {
  "type": "ota_start",
  "version": "v1.3.0",
  "size": 45056,
  "checksum": "a1b2c3d4",
  "block_size": 1024,
  "total_blocks": 44
}

OTA 数据块 {
  "type": "ota_block",
  "index": 12,
  "data": "<base64_encoded_1024_bytes>"
}

═══════════════════════════════════════════
MQTT 遗嘱消息 (Last Will)
═══════════════════════════════════════════

Topic: women_safe/{device_id}/state
Payload: {"type":"offline","ts":1625832000}
QoS: 1, Retain: true

设备断线时 broker 自动发布，APP 即时获知离线状态。
```

### 5.8 ADC 传感器驱动设计（MQ-2 / MQ-7 / 火焰）

**分层原则：采样归硬件，换算归 Lib，节奏归任务。**

```
TIM3 (100ms TRGO) ─触发→ ADC1 扫描 CH0/CH1/CH4 ─DMA循环→ g_adc_raw[3]
                                                            │
task_sensor.c 每周期读 g_adc_raw ─调用→ Lib 纯换算函数 ─→ 物理量 (ppm / 电压)
```

- DMA 缓冲区 `uint16_t g_adc_raw[3]` 的定义和 `HAL_ADC_Start_DMA()` 启动调用放在任务层
  （task_sensor.c），Lib 不持有硬件资源
- Lib 驱动（mq2/mq7/fire）只提供**纯换算函数**，形如 `float MQ7_RawToPPM(uint16_t raw)`：
  不含 HAL 调用、不含延时、不做采样 —— 天然满足"Lib 不依赖 FreeRTOS"规则
- 缓冲区下标约定：`[0]`=MQ-2 (Rank1/CH0)、`[1]`=MQ-7 (Rank2/CH1)、`[2]`=火焰 (Rank3/CH4)，
  各驱动头文件用 `MQx_ADC_INDEX` 宏固化此约定
- 均值/滑动滤波在 task_sensor.c 做（vTaskDelayUntil 节奏下累积），驱动里禁止 delay 轮询
- 换算要点（注意是两个不同的电压, 不能混用）：
  码值→电压用 **ADC 参考电压 3.3V**（`Vout = raw × 3.3 / 4096`）；
  分压反推 RS 用**传感器测量回路供电 5V**（`RS = (5.0 − Vout) × RL / Vout`, 模块 AO 取自 5V 分压）；
  曲线常数以数据手册拟合为准（MQ-7 CO: `ppm = 100.56×(RS/R0)^-1.521`,
  R0 = 100ppm CO 下的电阻, 个体 2~20kΩ 需逐只标定, RL 按模块丝印实测）；
  标定只能吸收系数 A 的偏差, **吸收不了指数 B 的偏差**, 网上代码的拟合常数必须先对照手册曲线验证再用
  （2026-07-17: 参考代码的 0.6549 指数与手册曲线 -1.52 不符, 已弃用）

> 改造记录 (2026-07-17)：网上参考的 SPL 版 MQ-7 驱动（自带 GPIO/ADC 初始化 + delay_ms
> 轮询均值）与本架构冲突，按上述原则重写为纯换算函数。mq2/fire 同理。

---

## 六、OTA 固件升级设计

### 6.1 整体流程

```

┌──────┐    ┌──────────┐    ┌───────────┐    ┌───────────┐
│ APP  │    │MQTT Broker│    │ ESP8266   │    │ STM32     │
└──┬───┘    └─────┬─────┘    └─────┬─────┘    └─────┬─────┘
   │              │               │                 │
   │ 上传 .bin    │               │                 │
   │─────────────►│               │                 │
   │              │               │                 │
   │ OTA 启动命令 │               │                 │
   │─────────────►│──────────────►│                │
   │              │               │ OTA_START cmd  │
   │              │               │───────────────►│
   │              │               │                 │ 进入 Bootloader
   │              │               │                 │ 擦除 App 区
   │              │               │  OTA_READY      │
   │              │               │◄────────────────│
   │              │               │                 │
   │ OTA 数据块×N │               │                 │
   │─────────────►│──────────────►│  串口分包转发   │
   │              │               │───────────────►│ 写入 Flash
   │              │               │  OTA_ACK/CKSUM  │
   │              │               │◄────────────────│
   │              │               │                 │
   │ 最后一块      │               │                 │
   │─────────────►│──────────────►│───────────────►│
   │              │               │  OTA_VERIFY     │ 校验 MD5/CRC32
   │              │               │  OTA_DONE       │
   │              │               │◄────────────────│
   │              │               │                 │ 跳转新固件
   │              │               │                 │
   │ 进度上报      │               │                 │
   │◄─────────────│◄──────────────│◄────────────────│

```

### 6.2 STM32 Bootloader 设计

```

Bootloader 入口 (0x08000000):

1. 检查 OTA 标志位 (备份寄存器或 Flash 最后一页)
2. 如果无 OTA 请求:
   - 校验 APP 区栈顶地址合法
   - 设置 VTOR = 0x08004000
   - 跳转到 APP 复位向量
3. 如果有 OTA 请求:
   - 初始化 USART2 (与 ESP8266 通信)
   - 等待 OTA 数据包
   - 每收到一个 block:
     a. 验证 block index 连续性
     b. 写入 Flash (0x08004000 + block_index * 1024)
     c. 回复 ACK/NAK
   - 收到 OTA_FINISH:
     a. 全固件 CRC32 校验
     b. 校验通过 → 清除 OTA 标志，软复位
     c. 校验失败 → 回复错误，等待重发

```

### 6.3 Flash 分区（64KB）

```

┌───────────────────────────── 0x08000000
│  Bootloader    16KB
│  (不可 OTA 更新)
├───────────────────────────── 0x08004000
│  Application   44KB
│  (OTA 更新区域)
├───────────────────────────── 0x0800F000
│  配置区        2KB
│  - 阈值参数
│  - WiFi 凭据
│  - 设备 ID
├───────────────────────────── 0x0800F800
│  OTA 临时标志   1KB
│  - 固件版本号
│  - 固件大小
│  - CRC32 期望值
│  - 升级进行中标志
├───────────────────────────── 0x0800FC00
│  报警日志       1KB
│  (循环写入, 最近 100 条)
└───────────────────────────── 0x08010000
```

---

## 七、ESP8266 固件设计

### 7.1 功能模块

```

ESP8266 固件 (Arduino):

├── WiFi 管理
│   ├── SmartConfig / 网页配网
│   ├── 断线自动重连
│   └── WiFi 信号强度上报
│
├── MQTT 客户端
│   ├── TLS 加密连接 (如需)
│   ├── 遗嘱消息配置
│   ├── 订阅下行 topic
│   └── 发布上行数据
│
├── UART 桥接 (与 STM32)
│   ├── 帧协议: STX + LEN + TYPE + PAYLOAD + CRC16 + ETX
│   ├── STM32 → ESP8266: 传感器数据 / 心跳 / 日志
│   └── ESP8266 → STM32: 控制命令 / 阈值配置 / OTA 数据
│
├── OTA 下载器
│   ├── MQTT 收到 OTA URL → HTTP GET 下载 .bin
│   ├── 分包传输给 STM32
│   ├── 进度上报
│   └── 超时重传机制
│
└── 自身 OTA (ArduinoOTA)
    └── ESP8266 自身固件升级
```

### 7.2 帧协议（STM32 ↔ ESP8266）

```

┌──────┬──────┬──────┬──────────┬──────┬──────┐
│ STX  │ TYPE │ LEN  │ PAYLOAD  │CRC16 │ ETX  │
│ 0xAA │ 1Byte│ 2Byte│ 0-255Byte│2Byte │ 0x55 │
└──────┴──────┴──────┴──────────┴──────┴──────┘

TYPE:
  0x01: 传感器数据上报
  0x02: 心跳
  0x03: 控制命令 (下行)
  0x04: 配置下发 (下行)
  0x10: OTA 启动 (下行)
  0x11: OTA 数据块 (下行)
  0x12: OTA ACK (上行)
  0x13: OTA 完成 (上行)
```

---

## 八、Android APP 重构设计

### 8.1 技术栈

| 层面 | 现有 | 重构后 |
| --- | --- | --- |
| 语言 | Java | Kotlin |
| 架构 | MVC（单 Activity 大杂烩） | MVVM (ViewModel + Repository) |
| MQTT | 自写 Service | Eclipse Paho MQTT + WorkManager 保活 |
| UI | XML + 基础控件 | Jetpack Compose 或 Material Design 3 + ViewBinding |
| 通知 | — | Firebase Cloud Messaging (FCM) + 本地 Notification |
| 图表 | — | MPAndroidChart / Vico |
| 持久化 | — | Room 数据库（报警记录 / 设备配置） |
| 网络 | — | Retrofit2 + OkHttp |

### 8.2 功能模块

```

APP 功能结构:

├── 首页仪表盘
│   ├── 设备在线状态卡片
│   ├── 温度/湿度/烟雾/CO 实时数值
│   ├── 布防/撤防 滑动开关
│   └── 快捷操作 (紧急报警 / SOS)
│
├── 实时监控
│   ├── 传感器数值曲线 (温度/湿度/烟雾 历史趋势)
│   ├── PIR/雷达 活动时间线
│   └── 设备日志流
│
├── 报警中心
│   ├── 报警记录列表 (按时间排序)
│   ├── 报警详情 (触发原因 / 传感器数值快照)
│   └── 误报标记 (帮助优化阈值)
│
├── 设备管理
│   ├── 设备列表 (支持多台设备)
│   ├── 添加设备 (扫描二维码 / MQTT 发现)
│   ├── 固件升级 (检查更新 / OTA 进度)
│   └── 设备配置 (阈值 / 灵敏度 / 报警方式)
│
├── 指纹管理
│   ├── 指纹列表 (编号 + 标签)
│   ├── 添加指纹 (APP 触发 → STM32 录入 → 结果回传)
│   └── 删除指纹
│
└── 设置
    ├── 定时布防 (列表 + 添加/编辑规则, 时间选择器 + 星期多选 + 启用开关)
    ├── 通知偏好
    ├── MQTT Broker 配置
    ├── 紧急联系人
    └── 关于 / 帮助
```

### 8.3 MQTT 服务架构

```

MqttService (Foreground Service)
├── 连接管理: 断线重连 / 心跳
├── 订阅 topic: women_safe/+/state, women_safe/+/log
├── 发布 topic: women_safe/{id}/cmd, women_safe/{id}/config
└── WorkManager 保活: 周期性唤醒，确保不被系统杀死

MqttRepository (单例)
├── Observable state: StateFlow<DeviceState></devicestate>
├── Observable logs: StateFlow<List<AlarmLog></alarmlog>>
└── suspend fun sendCommand(deviceId, command)

MainViewModel
├── uiState: StateFlow<MainUiState></mainuistate>
├── devices: StateFlow<List<Device></device>>
└── onArm(), onDisarm(), onUpdateThreshold()
```

---

## 九、实现阶段划分

### Phase 1: 基础环境搭建（2 天）

```

□ CubeMX 按上述配置生成工程
□ 验证 FreeRTOS 调度器跑起来（点灯任务）
□ 移植/编写基础驱动:
  □ GPIO 输入输出
  □ USART1/2/3（中断 + DMA）
  □ ADC1（DMA 循环采样）
  □ I2C1 + OLED 显示
  □ TIM2/TIM3 定时器
㉎ RTC 时钟
□ 驱动验收：每个外设单独测试通过
```

### Phase 2: FreeRTOS 任务移植（2 天）

```

□ 实现 SensorTask（读取所有传感器）
□ 实现 SecurityTask（融合判定 + 状态机）
□ 实现 AlarmTask（蜂鸣器 + RGB + 语音）
□ 实现 UITask（OLED 显示 + 按键）
□ 实现任务间 IPC（队列 + 信号量）
□ 集成测试：所有任务协同运行
```

### Phase 3: MQTT + ESP8266（2 天）

```

□ ESP8266 固件编写（Arduino IDE）:
  □ WiFi 连接 + SmartConfig 配网
  □ MQTT 连接 + 遗嘱消息
  □ UART 帧协议收发
  □ 心跳定时发布
□ STM32 CommTask 实现:
  □ 帧协议打包/解包
  □ MQTT JSON 构建/解析
  □ 命令分发到其他任务
□ 端到端测试：
  □ APP 看到实时传感器数据
  □ APP 控制布防/撤防成功
  □ APP 修改阈值同步到 STM32
```

### Phase 4: OTA 升级（3 天）

```

□ STM32 Bootloader 开发:
  □ Flash 分区与擦写驱动
  □ 固件校验（CRC32）
  □ APP 跳转逻辑
□ STM32 OTATask 实现:
  □ OTA 数据接收状态机
  □ 块序号校验 / 重传请求
  □ Flash 写入 / 校验 / 确认
□ ESP8266 OTA 下载器:
  □ HTTP GET 下载固件
  □ 分包转发到 STM32
  □ 进度上报
□ APP OTA 界面:
  □ 固件版本检查
  □ 上传固件包
  □ 实时进度条
□ 端到端测试：
  □ 一次完整 OTA 升级成功
  □ OTA 中断恢复测试
  □ OTA 固件校验失败回退测试
```

### Phase 5: Android APP 重构（3-5 天）

```

□ 项目搭建 (Kotlin + MVVM + Gradle KTS)
□ MQTT Repository + Service 实现
□ 首页仪表盘 UI
□ 实时监控 + 曲线图
□ 报警中心 + 通知推送
□ 设备管理（多设备 + OTA + 配置）
□ 指纹管理页面
□ 设置页面
□ 整体测试 + Bug 修复
```

### Phase 6: 收尾优化（1-2 天）

```

□ 传感器自检功能
□ 报警日志存储与查看
□ 低功耗策略
□ 整体压力测试（72h 连续运行）
□ 文档整理
```

---

## 十、注意事项

1. **CubeMX FreeRTOS 版本**：CubeMX 自带的 FreeRTOS 版本可能较旧（一般 CMSIS_RTOS_V2 wrapper），推荐使用 CubeMX 包管理器下载最新版。
2. **ESP8266 帧协议**：一定要从现有的"文本行解析"改为**二进制帧协议**（带 CRC 校验），否则 OTA 传输不可靠。
3. **MCU Flash 寿命**：STM32F103C8T6 Flash 擦写次数约 10,000 次。报警日志和配置存储需做磨损均衡（每次写不同位置，循环使用）。
4. **OTA 安全性**：

   - 固件必须做完整性校验（CRC32 + MD5）
   - 必须做版本号检查（不能降级到旧版本有已知漏洞的固件）
   - 可选：固件数字签名（RSA/ECDSA），防止恶意固件
5. **MQTT Broker**：目前用的是公网 IP `117.72.167.226:1883`，建议：

   - 开发阶段：自建 Mosquitto (Docker) 或使用 EMQX Cloud 免费版
   - 生产阶段：阿里云 IoT / 华为云 IoT，自带设备管理和 OTA 服务
6. **SRAM 预算**：STM32F103C8T6 只有 20KB SRAM，需要精打细算：

   - FreeRTOS heap: 10KB
   - 任务栈: 约 3KB
   - 驱动 buffer: 约 2KB
   - 用户数据: 约 3KB
   - 余量: 约 2KB

   建议所有 Buffer 用静态分配，OTA 传输时用流式写入避免大量缓存。

---

> **最后提醒**：这个计划是一个"学习和展示"级的完整方案。你可以按需裁剪——比如只做 Phase 1-3 就能得到一个功能完整的 FreeRTOS + MQTT 项目，Phase 4 的 OTA 是加分项，Phase 5 的 APP 重构是锦上添花。关键是**步步验证**，每个 Phase 跑通再进入下一个。
