Jzoe-hub/NightSecurityProject/docs/项目说明书.md

# 女性安防系统 — 项目说明书

> 本说明书描述系统整体设计框架、算法方案和功能规划。
> 部分功能当前仅实现简化版，文档标注"待实现"表示规划中的完整方案。

---

## 1. 系统架构

```
┌─────────────────────────────────────────────┐
│                   Android APP               │  Phase 5
├─────────────────────────────────────────────┤
│         MQTT Broker (117.72.167.226)        │  Phase 3
├─────────────────────────────────────────────┤
│              ESP8266 WiFi 模块              │  Phase 3
├─────────────────────────────────────────────┤
│          STM32F103C8T6 + FreeRTOS           │  Phase 2 ← 当前
│  ┌─────────┐  ┌──────────┐  ┌────────────┐ │
│  │SensorTask│→│SecurityT.│→│  AlarmTask  │ │
│  │ 采集滤波 │  │ 融合判定 │  │ 声光报警    │ │
│  └─────────┘  └──────────┘  └────────────┘ │
│                    ↓                       │
│  ┌─────────┐  ┌──────────┐                 │
│  │ UITask  │  │WatchdogT.│                 │
│  │ OLED+键 │  │ 心跳喂狗 │                 │
│  └─────────┘  └──────────┘                 │
└─────────────────────────────────────────────┘
```

---

## 2. 硬件清单

| 类别 | 模块 | 引脚 | 用途 |
| --- | --- | --- | --- |
| 主控 | STM32F103C8T6 | — | FreeRTOS 多任务调度 |
| 烟雾 | MQ-2 (AO) | PA0/ADC1_IN0 | 烟雾浓度 |
| CO | MQ-7 (AO) | PA1/ADC1_IN1 | 一氧化碳浓度 |
| 火焰 | 火焰传感器 (AO+DO) | PA4/ADC1_IN4 + PA11 | 明火检测 |
| 温湿度 | DHT11 | PA12 | 温度+湿度 |
| PIR | HC-SR501 | PA8 | 人体红外 |
| 雷达 | LD2410C (UART) | PA9/TX PA10/RX | 运动/静止目标 |
| 指纹 | ZW101 (UART) | PB10/TX PB11/RX PA6/TOUCH | 授权验证 |
| 语音 | JQ8900-16P (IO) | PB6/IO1 PB7/IO2 PB3/IO3 PB4/IO4 PB12/BUSY | 语音播报 |
| OLED | SSD1306 (I2C) | PB8/SCL PB9/SDA | 本地显示 |
| 蜂鸣器 | 有源蜂鸣器 | PA5 | 报警声响 |
| RGB | 5050 共阳 | PB0/R PB1/G PA7/B | 报警灯效 |
| 按键 | ×3 | PB13/K1 PB14/K2 PB15/K3 | 交互操作 |
| WiFi | ESP8266 (UART) | PA2/TX PA3/RX | MQTT 通信 |

---

## 3. 传感器采样与滤波算法

### 3.1 卡尔曼 + EWMA 联合滤波 (待实现)

对 MQ-2 烟雾和 MQ-7 CO 的 ADC 采样值做两级平滑:

```
ADC 原始值 → Kalman 滤波 (抑制突变) → EWMA 指数加权 (去除毛刺) → 稳定值
```

- **Kalman**: 对传感器物理过程建模, 预测下一时刻值, 与实际采样值融合
- **EWMA**: `S_new = α × S_old + (1-α) × V_new`, α≈0.3~0.4

`S_new` — 本次滤波后的输出值（发给 SecurityTask）

`S_old` — 上一次滤波后的值（用 static 变量保存）

`V_new` — 本次传感器原始读数

`α` — 平滑系数，0~1，越大越平滑但响应越慢

- 作用: 消除 ADC 抖动、供电噪声、瞬时干扰

### 3.2 EWMA 入侵置信度平滑 (待实现)

对入侵融合分值做平滑:

```
入侵原始分 → EWMA(filter=40) → 平滑后的入侵置信度
```

- 避免 PIR 瞬时触发一次就报警
- 雷达信号抖动被平滑掉

### 3.3 当前实现状态 (2026-08-04 更新)

#### 已实现：中值滤波 + EWMA 组合

SensorTask 的 `publish_sensor_data()` 中已对 4 路模拟量加入软件滤波:

| 传感器 | 滤波方案 | α 值 | 说明 |
| --- | --- | ----- | --- |
| 火焰 (AO)  | 中值(窗口3) + EWMA | 0.70  | 先剔除单采样尖峰, 再指数平滑 |
| MQ-2 烟雾  | EWMA | 0.85  | 气体变化慢, 强平滑 |
| MQ-7 CO | EWMA | 0.85  | 气体变化慢, 强平滑 |
| DHT11 温度 | EWMA | 0.90  | 温度变化极慢, 最强平滑 |

#### 火焰传感器滤波效果 (STAR 数据)

| 指标 | 滤波前 | 滤波后 |
| --- | --- | --- |
| 无火焰状态数值范围 | 0 ~ 300 (剧烈跳动) | 155 ~ 175 (稳定) |
| 单次采样尖峰 | 直接传给 SecurityTask, 引发误报 | 中值滤波直接丢弃 |
| 响应延迟 | 0 (原始值) | 约 300ms (中值3窗口×100ms + EWMA滞后) |

> **解读**: 火焰传感器 (红外光电管) 对室内灯光、自然光变化敏感,
> 原始 ADC 值在无明火时也会大幅抖动。
> 加入中值+EWMA 两重滤波后, 无火基线稳定在 155~175,
> 为后续 `th_fire` 阈值标定提供了可靠基础。

#### 未实现 (Phase 6)

- 卡尔曼滤波: STM32F103 算力受限, EWMA 已满足需求, 不再引入
- 入侵置信度 EWMA 平滑: 待实测后按需加入

---

## 4. 火灾判定算法

### 4.1 设计权重

| 传感器 | 权重 | 说明 |
| --- | ---- | --- |
| 温度 (DHT11) | 70 | 室内异常升温是火灾最可靠特征 |
| 烟雾 (MQ-2) | 55 | 烟雾浓度上升 |
| CO/气体 (MQ-7) | 40 | 可燃气体/CO 检测 |
| 火焰传感器 | 5 | 辅助参考(静态不稳定, 低权) |

### 4.2 判定条件 (满足任一)

1. 温度超阈值
2. 烟雾 + 温度 同时超阈值
3. 烟雾 + 气体 同时超阈值
4. 温度 + 气体 同时超阈值
5. 加权总分 ≥ 60

### 4.3 当前实现

Phase 2 当前代码使用简化版: 四项独立投票(40+30+20+10), ≥30 预警 ≥60 报警。
阈值可在 OLED 设置页实时调节。

---

## 5. 入侵判定算法

### 5.1 设计权重

| 传感器 | 权重 | 说明 |
| --- | ---- | --- |
| PIR 红外 | 70 | 人体检测主要来源 |
| 雷达 (LD2410C) | 10 | 辅助参考(室内多径干扰) |

### 5.2 判定流程

```
PIR触发(70) + 雷达目标(10) → EWMA平滑(filter=40) → 稳定置信度
稳定置信度 ≥ 60 → 入侵报警
```

### 5.3 当前实现

Phase 2 使用简化版: PIR+雷达有人=30, 距离<200cm=15, 运动=25, 静止=50, ≥60 报警。

---

## 6. 状态机设计

```
撤防(DISARMED) ──(布防按键)──→ 布防(ARMED)
     │                              │
     │                         (触发判定)
     │                              ↓
     │                         预警(WARNING)
     │                         (连续3次确认)
     │                              ↓
     │                         报警(ALARM)
     │                         (蜂鸣器+RGB+语音)
     │                              │
     └────────(撤防按键)────────────┘
```

- 撤防态: 只显示数据, 不触发任何报警
- 布防态: 检测火灾+入侵
- 预警态: 连续 3 次判定≥1 转报警, 连续安全转布防
- 报警态: 保持, 等撤防指令解除

---

## 7. 声光报警策略

| 报警类型  | 蜂鸣器 | RGB | 语音 |
| --- | --- | --- | --- |
| 火灾预警  | — | — | — |
| 火灾报警  | 长鸣 | 红色常亮 | IO1 播报"火灾" |
| 入侵预警  | — | — | — |
| 入侵报警  | 短促鸣叫 | 蓝色闪烁 | IO2 播报"入侵" |
| 火灾+入侵 | 长鸣(火优先) | 红色常亮(火优先) | IO1 播报 |
| 正常 | 不响 | 绿色常亮 | 不触发 |

---

## 8. 指纹与语音联动 (待硬件)

### 8.1 指纹验证流程

```
手指触摸 TOUCH 引脚 → ZW101 取图 → 搜索指纹库 → 比对
成功: 语音 IO1 播报 → 解除报警 → 撤防
失败: 语音 IO2 播报 → 保持报警
```

### 8.2 指纹注册

Phase 5 通过 APP 远程录入, ZW101 上位机可预录。

---

## 9. MQTT 通信协议 (Phase 3)

### 上行 (STM32 → APP)

Topic: `women_safe/state`

```json
{"temp":28,"humi":46,"smoke":3,"co":1,"pir":0,"fire":0,"armed":1}
```

### 下行 (APP → STM32)

Topic: `women_safe/cmd`

```json
{"type":"threshold","t":22,"smoke":10,"co":10}
{"type":"arm","armed":1}
```

---

## 10. OTA 固件升级 (Phase 4)

### 10.1 Flash 分区

64K Flash 划分为三段：

```
Bootloader  8K  (0x08000000 ~ 0x08001FFF)  引导程序，永不升级
APP        55K  (0x08002000 ~ 0x0800FBFF)  业务程序，可升级
标志页      1K  (0x0800FC00 ~ 0x0800FFFF)  升级标志（魔数 0x5AA5）
```

> F103C8T6 标称 64K Flash，做不了标准 A/B 双分区，采用「单区 + 边收边写 + 标志位兜底」方案。

### 10.2 升级流程

```
APP 正常跑
  ↓ 收到升级指令（/cmd JSON "ota"）
APP 写升级标志(0x5AA5) → NVIC_SystemReset 重启
  ↓
Bootloader 上电查标志
  ├─ 无标志 → 直接跳 APP（正常开机）
  └─ 有标志 → 进升级模式
        ↓ 收固件块（START / DATA / END）
      擦除 + 写 Flash + 单帧 CRC
        ↓ 整包 CRC 通过
      清标志 → 跳新 APP
        （校验失败 / 断电 → 标志保留，下次开机重进升级模式）
```

### 10.3 帧协议扩展

复用现有帧格式（STX 0xAA + TYPE + LEN + PAYLOAD + CRC16 + ETX 0x55），新增 4 种 TYPE：

| TYPE | 帧 | 方向 | PAYLOAD |
| ---- | --- | ---- | --- |
| 0x05 | OTA_START  | 下行 | 总大小(4B) + 总CRC(2B)  |
| 0x06 | OTA_DATA | 下行 | 块序号(2B) + 数据(126B) |
| 0x07 | OTA_END | 下行 | 空 |
| 0x08 | OTA_ACK | 上行 | 状态(1B) + 块序号(2B) |

### 10.4 无线链路与 Topic

```
手机/APP ──MQTT──> EMQX ──WiFi──> ESP8266 ──UART──> STM32
```

| Topic | 方向 | 内容 |
| --- | ---- | --- |
| /cmd | 下行 | 升级指令（JSON `"action":"ota"`）|
| /fw/start  | 下行 | 固件开始（总大小+总CRC） |
| /fw/data | 下行 | 固件数据块 |
| /fw/end | 下行 | 固件结束 |
| /fw/ack | 上行 | 升级应答 |

### 10.5 可靠性设计

- **单帧 CRC + 整包 CRC**：保证每帧和整体数据完整
- **升级标志位**：断电兜底，失败自动重进升级模式
- **ESP8266 透明桥接**：不碰固件内容，只转发

---

## 11. Phase 规划

| Phase | 内容 | 状态 |
| --- | --- | --- |
| Phase 1 | 硬件 + CubeMX + 全部驱动 | ✅ |
| Phase 2 | FreeRTOS 任务 + 本地联动 | ✅ |
| Phase 3 | MQTT + ESP8266 | ✅ |
| Phase 4 | OTA 固件升级 | ✅ |
| Phase 5 | Android APP (Kotlin MVVM)  | 🔄 雏形 |
| Phase 6 | 优化: 卡尔曼滤波, 磨损均衡 | ⬜ |

---

## 12. 遇到的问题

详见 [问题记录.md](问题记录.md)（全部 1现象→2排查/解法→3根因 格式）
