Jzoe-hub/NightSecurityProject/Hardware/BOM_Board1_Schematic1_2026-07-16.xlsx

No. | Quantity | Comment | Designator | Footprint | Value | Manufacturer Part | Manufacturer | Supplier Part | Supplier
1 | 2 | 100nF | C1,C4 | C0603 | 100nF | CC0603KRX7R9BB104 | YAGEO(国巨) | C14663 | LCSC
2 | 1 | 10uF | C2 | C0603 | 10uF | CL10A106KP8NNNC | SAMSUNG(三星) | C19702 | LCSC
3 | 1 | 22uF | C3 | C0603 | 22uF | CGA0603X5R226M160JT | HRE(芯声) | C6119868 | LCSC
4 | 2 | MQ2 | MQ2,MQ7 | MQ2
5 | 1 | MC096GW | OLED1 | OLED-TH_4P-L27.8-W27.3_MC096GW |  | MC096GW |  | C9900209498 | LCSC
6 | 1 | DHT11 | P1 | DHT11
7 | 2 | 5.1kΩ | R1,R2 | R0603 | 5.1kΩ | 0603WAF5101T5E | UNI-ROYAL(厚声) | C23186 | LCSC
8 | 3 | TS665CJ | S1,S2,S3 | SW-TH_4P-L6.0-W6.0-P4.50-LS6.5 |  | TS665CJ | SHOU HAN(首韩) | C393938 | LCSC
9 | 1 | ZX-XH2.54-2PZZ | SPK1 | CONN-TH_2P-P2.50_HX25003-2A |  | ZX-XH2.54-2PZZ | Megastar(兆星) | C7429632 | LCSC
10 | 1 | JQ8900语音模块 | U1 | JQ8900语音模块_1
11 | 1 | AMS1117-3.3 | U2 | SOT-89-3_L4.5-W2.5-P1.50-LS4.2-BR |  | AMS1117-3.3 | Slkor(萨科微) | C880752 | LCSC
12 | 1 | STM32F103C8T6-Card | U3 | CONN-TH_L53.3-W22.9_STM32F103C8T6-CARD |  | STM32F103C8T6-Card |  | C9900077949 | LCSC
13 | 1 | 有源蜂鸣器模块 | U4 | 有源蜂鸣器模块
14 | 1 | RGB单灯珠模块 | U5 | RGB单灯珠模块
15 | 1 | 火焰传感器模块 | U6 | 火焰传感器模块
16 | 1 | ESP8266-01S | U7 | WIFIM-TH_ESP8266-01S |  | ESP8266-01S |  | C9900150497 | LCSC
17 | 1 | SR501 | U8 | HC-SR501_W32_H24
18 | 1 | LD2410C | U9 | LD2410C
19 | 1 | ZW101 | U10 | ZW101
20 | 1 | KH-TYPE-C-16P | USB2 | USB-C-SMD_KH-TYPE-C-16P |  | KH-TYPE-C-16P | kinghelm(金航标) | C709357 | LCSC
