Jzoe-hub/NightSecurityProject/Hardware/SCH_Schematic1_2026-07-16.pdf

# 5V-3V3VIN

主控

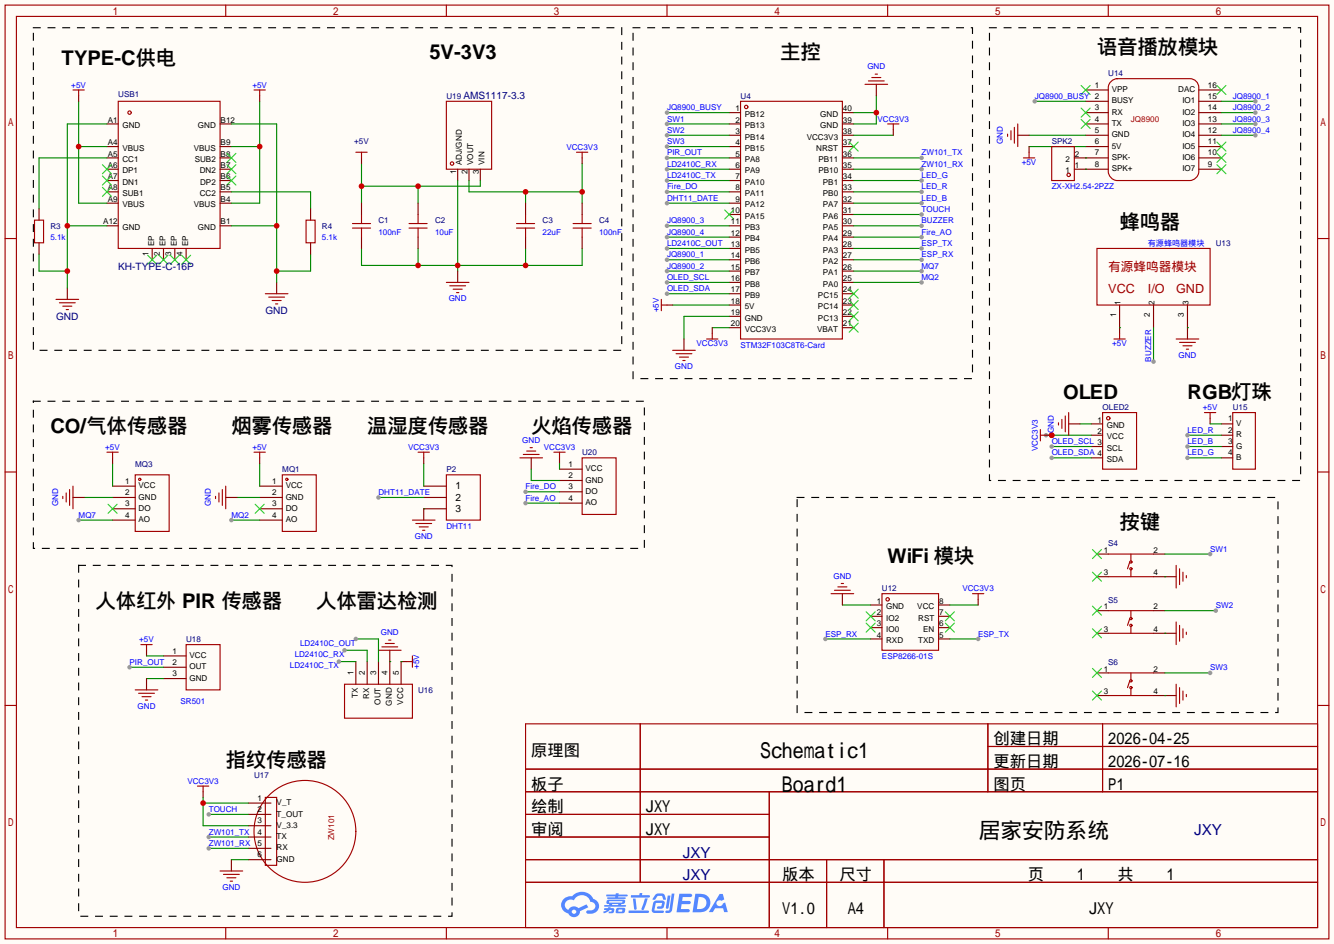
[picture p1: page 1]

原理图 | Schematic1 | 创建日期 | 2026-04-25

更新日期 | 2026-07-16

板子 | Board1 | 图页 | P1
绘制 | JXY | 居家安防系统 JXY
审阅 | JXY

JXY
JXY | 版本 | 尺寸 | 页 1 共 1

V1.0 | A4 | JXY
