Jzoe-hub/NightSecurityProject/software/NightSecurity/NightSecurity.ioc

Mcu.UserName=STM32F103C8Tx
PA0-WKUP.GPIO_Label=MQ2
PA0-WKUP.Signal=ADCx_IN0
PA1.GPIO_Label=MQ7
PA1.Signal=ADCx_IN1
PA10.GPIO_Label=LD2410C_TX
PA10.Signal=USART1_RX
PA11.GPIO_Label=Fire_DO
PA11.Signal=GPIO_Input
PA12.GPIO_Label=DHT11_DATE
PA12.Signal=GPIO_Output
PA13.Signal=SYS_JTMS-SWDIO
PA14.Signal=SYS_JTCK-SWCLK
PA2.GPIO_Label=ESP_RX
PA2.Signal=USART2_TX
PA3.GPIO_Label=ESP_TX
PA3.Signal=USART2_RX
PA4.GPIO_Label=Fire_AO
PA4.Signal=ADCx_IN4
PA5.GPIO_Label=BUZZER
PA5.Signal=GPIO_Output
PA6.GPIO_Label=TOUCH
PA6.Signal=GPXTI6
PA7.GPIO_Label=LED_B
PA7.Signal=GPIO_Output
PA8.GPIO_Label=PIR_OUT
PA8.Signal=GPIO_Input
PA9.GPIO_Label=LD2410C_RX
PA9.Signal=USART1_TX
PB0.GPIO_Label=LED_R
PB0.Signal=GPIO_Output
PB1.GPIO_Label=LED_G
PB1.Signal=GPIO_Output
PB10.GPIO_Label=ZW101_RX
PB10.Signal=USART3_TX
PB11.GPIO_Label=ZW101_TX
PB11.Signal=USART3_RX
PB12.GPIO_Label=JQ8900_BUSY
PB12.Signal=GPIO_Input
PB13.GPIO_Label=SW1
PB13.Signal=GPIO_Input
PB14.GPIO_Label=SW2
PB14.Signal=GPIO_Input
PB15.GPIO_Label=SW3
PB15.Signal=GPIO_Input
PB3.GPIO_Label=JQ8900_3
PB3.Signal=GPIO_Output
PB4.GPIO_Label=JQ8900_4
PB4.Signal=GPIO_Output
PB5.GPIO_Label=LD2410C_OUT
PB5.Signal=GPXTI5
PB6.GPIO_Label=JQ8900_1
PB6.Signal=GPIO_Output
PB7.GPIO_Label=JQ8900_2
PB7.Signal=GPIO_Output
PB8.GPIO_Label=OLED_SCL
PB8.Signal=I2C1_SCL
PB9.GPIO_Label=OLED_SDA
PB9.Signal=I2C1_SDA
PC13-TAMPER-RTC.Signal=GPIO_Output
PC14-OSC32_IN.Signal=RCC_OSC32_IN
PC15-OSC32_OUT.Signal=RCC_OSC32_OUT
PD0-OSC_IN.Signal=RCC_OSC_IN
PD1-OSC_OUT.Signal=RCC_OSC_OUT
