Jzoe-hub/NightSecurityProject/software/NightSecurity/Core/Src/main.c

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
/* Includes ------------------------------------------------------------------*/
#include "main.h"
#include "cmsis_os.h"
#include "adc.h"
#include "dma.h"
#include "i2c.h"
#include "iwdg.h"
#include "rtc.h"
#include "tim.h"
#include "usart.h"
#include "gpio.h"

/* USER CODE BEGIN Includes */
#include "oled.h"
#include "mq7.h"
#include "buzzer.h"
#include "esp8266.h"
#include "radar.h"
#include <stdio.h>
/* USER CODE END Includes */


/* USER CODE BEGIN PV */
uint16_t g_adc_raw[3] = {0};//ADC DMA 缓冲区：TIM3 每 100ms 触发一次扫描, 3 通道结果由 DMA 自动填入
/* USER CODE END PV */

void SystemClock_Config(void);
void MX_FREERTOS_Init(void);
/**
  * @brief  The application entry point.
  * @retval int
  */
int main(void)
{

  /* MCU Configuration--------------------------------------------------------*/

  /* Reset of all peripherals, Initializes the Flash interface and the Systick. */
  HAL_Init();

  /* Configure the system clock */
  SystemClock_Config();

  /* Initialize all configured peripherals */
  MX_GPIO_Init();
  MX_DMA_Init();
  MX_ADC1_Init();
  MX_USART1_UART_Init();
  MX_USART2_UART_Init();
  MX_USART3_UART_Init();
  MX_I2C1_Init();
  MX_RTC_Init();
  MX_TIM2_Init();
  MX_TIM3_Init();
  MX_IWDG_Init();
  /* USER CODE BEGIN 2 */
  /* ====== 调试: 验证 OLED 硬件正常 ====== */
  OLED_Init();
  OLED_Clear();
  OLED_PrintString(0, 0, "OLED OK");
  HAL_Delay(2000);

  /* 初始化外设默认状态 */
  Buzzer_Off();                                        /* 蜂鸣器初始关 */
  Radar_Init();                                        /* 雷达 DMA 接收启动    */
  Esp8266_Init();                                      /* ESP8266 DMA 接收启动 */

  /* 启动 ADC DMA 供 SensorTask 使用 */
  HAL_TIM_Base_Start(&htim3);
  HAL_ADC_Start_DMA(&hadc1, (uint32_t*)g_adc_raw, 3);
  /* USER CODE END 2 */

  /* Init scheduler */
  osKernelInitialize();  /* Call init function for freertos objects (in cmsis_os2.c) */
  MX_FREERTOS_Init();

  /* Start scheduler */
  osKernelStart();

  /* We should never get here as control is now taken by the scheduler */

  /* Infinite loop */
  /* USER CODE BEGIN WHILE */
  while (1)
  {

    /* USER CODE END WHILE */

    /* USER CODE BEGIN 3 */
  }
  /* USER CODE END 3 */
}

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
/**
  * @brief  Period elapsed callback in non blocking mode
  * @note   This function is called  when TIM4 interrupt took place, inside
  * HAL_TIM_IRQHandler(). It makes a direct call to HAL_IncTick() to increment
  * a global variable "uwTick" used as application time base.
  * @param  htim : TIM handle
  * @retval None
  */
void HAL_TIM_PeriodElapsedCallback(TIM_HandleTypeDef *htim)
{
  if (htim->Instance == TIM4)
  {
    HAL_IncTick();
  }
}

/**
  * @brief  This function is executed in case of error occurrence.
  * @retval None
  */
void Error_Handler(void)
{
  /* USER CODE BEGIN Error_Handler_Debug */
  /* User can add his own implementation to report the HAL error return state */
  __disable_irq();
  while (1)
  {
  }
  /* USER CODE END Error_Handler_Debug */
}
#ifdef USE_FULL_ASSERT
/**
  * @brief  Reports the name of the source file and the source line number
  *         where the assert_param error has occurred.
  * @param  file: pointer to the source file name
  * @param  line: assert_param error line source number
  * @retval None
  */
void assert_failed(uint8_t *file, uint32_t line)
{
  /* USER CODE BEGIN 6 */
  /* User can add his own implementation to report the file name and line number,
     ex: printf("Wrong parameters value: file %s on line %d\r\n", file, line) */
  /* USER CODE END 6 */
}
#endif /* USE_FULL_ASSERT */
