Jzoe-hub/NightSecurityProject/(commit log)

2026-07-12 初始化项目结构：文档、硬件原理图、gitignore
2026-07-12 gitignore：排除个人学习笔记
2026-07-16 完成cubemx配置，硬件sr501的供电改为5V、esp8266天线下挖空铺铜区
2026-07-16 更新原理图
2026-07-17 搭建项目代码结构：新增用户层的硬件驱动Lib和任务函数Task文件夹
    [BOM_Board1_Schematic1_2026-07-16.xlsx, NightSecurity Debug.cfg, PickAndPlace_PCB1_2026_07_16.xlsx]
2026-07-18 Fix:ADC三通道扫描的配置，由tim3TRGO触发加定时器分频系数的纠正
2026-07-18 移植OLED和MQ7的驱动
2026-07-18 编写MQ7+OLED联调测试；更新了项目计划和交接文档
2026-07-18 新增MQ2和fire传感器驱动
2026-07-20 完成了剩下所有硬件驱动的移植
2026-07-28 创建本地功能所需任务，完成SensorTask任务函数文件编写，未完成队列同步
2026-07-29 编写security任务函数文件，队列同步sensor和security
2026-07-29 完成AlarmTask任务文件，以及Security与ALarm的同步
2026-07-30 完成ui显示和指纹验证任务编写（指纹注册放在后续app）
2026-07-30 完成看门狗任务
2026-07-30 优化显示界面，阈值设置逻辑，布防撤防逻辑；
    [NightSecurity Debug.cfg]
2026-07-30 重构计划、调试手册、项目说明书优化
2026-08-04 feat: 增加EWMA+中值滤波，火焰数值0~300→155~175稳定; 更新项目说明书数据
2026-08-07 feat:完成 — MQTT+ESP8266上云 + Android APP雏形接入EMQX- STM32: CommTask合并EspRxTask逻辑, 帧协议CRC16, USART2 DMA+IDLE接收 - ESP8266: TLS+MQTT桥接固件(Arduino), WiFi+遗嘱消息+心跳 - Android: Jetpack Compose仪表盘, Paho MQTT订阅传感器实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
2026-08-08 feat: APP三页导航+MQTT实时数据+紧急拨号+阈值下发
    - 底部导航: 仪表盘/紧急求助/设置 三页切换
    - 仪表盘: 添加滚动MQTT原始JSON日志(黑底绿字,50条)
    - 紧急求助: 号码输入+一键拨号按钮(跳转系统拨号器)
    - 设置: 阈值可编辑输入框+保存下发到设备(config topic)
    - MqttRepository单例共享, 原始数据带时间戳
    - 替换EMQX SDK→Paho MQTT(Maven Central可用)
    [BOM_Board1_Schematic1_2026-07-16.xlsx, PickAndPlace_PCB1_2026_07_16.xlsx]
2026-08-08 feat: APP三页导航+阈值跨页保持; fix: PIR下拉+MQ2接线; docs: 问题记录面试格式; 项目说明书更新滤波数据+Phase状态
    [NightSecurity.ioc, main.c, task_security.c]
2026-08-15 feat: 语音IO3/IO4+指纹验证启用+App布防撤防双按钮
    - 语音: IO3指纹成功/IO4布防成功, 报警语音周期播报+布防冷却
    - 指纹: FingerTask启用, TOUCH检测加200ms延时提升识别率, 成功撤防+语音
    - App: 布防/撤防改为独立双按钮, 去掉乐观更新避免状态跳变
    - 阈值: arm/disarm精确匹配防误判, rx.json清零
    - 堆优化: TimerTask/Security/UI/CloudRxPacket/g_cmdQueue 共省~1.5KB
    - 删_printf_float省Flash
    - docs: 问题记录补充指纹启用堆溢出案例
    [task_alarm.c, task_comm.c, task_config.h, task_finger.c, task_security.c]
2026-08-20 feat: Phase4 OTA固件升级完整闭环(Bootloader+APP+ESP8266+Android)
    - STM32: Bootloader工程(分区8K+55K+1K/IAP跳转/帧状态机/CRC16/写Flash/升级标志位断电兜底) + APP写标志NVIC_SystemReset + 升级指令改/cmd JSON下发
    - ESP8266: 固件块MQTT↔UART透明转发(/fw/start|data|end+/fw/ack, MQTT_MAX_PACKET_SIZE调512)
    - Android: OtaScreen选固件+进度条 + MqttRepository OTA方法(126B分块+CRC16)
    - 文档: 项目说明书新增OTA章节 + 问题记录 + OTA学习笔记.html图文版
    - chore: 修复.gitignore(行尾注释致规则失效), 清理误追踪的Debug编译产物/.settings/串口工具配置
    [config.txt]
