Jzoe-hub/NightSecurityProject/(notices)

Notices in the files:
software/NightSecurity/Core/Src/main.c:
Copyright (c) 2026 STMicroelectronics.
All rights reserved.
This software is licensed under terms that can be found in the LICENSE file
